Apollo-kernel/mechatronics/M0603A快速使用.pdf

# 快速使用步骤：

①先需要准备一个 USB 转 TTL 模块
②电脑准备一个串口调试助手上位机
③准备一个直流电源，按图示接好线，转接板的 TX 接串口 TX，RX 接串口 RX（如果不行可尝试交叉）

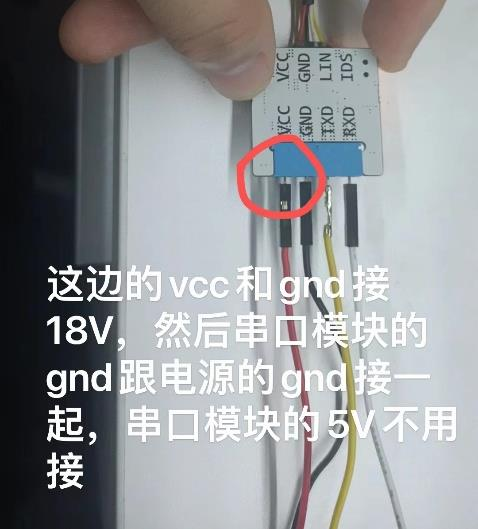
[picture p8: figure]

④固定好电机，电机为外转子（必须固定，电流环下电机会高速旋转） ⑤电源电压调至 18V,限流 1A
⑥串口助手配置

⑦上电后，串口助手先发使能指令（把转接板 ID 拨码拨至 ID1，中途改 ID 需要重新上电）

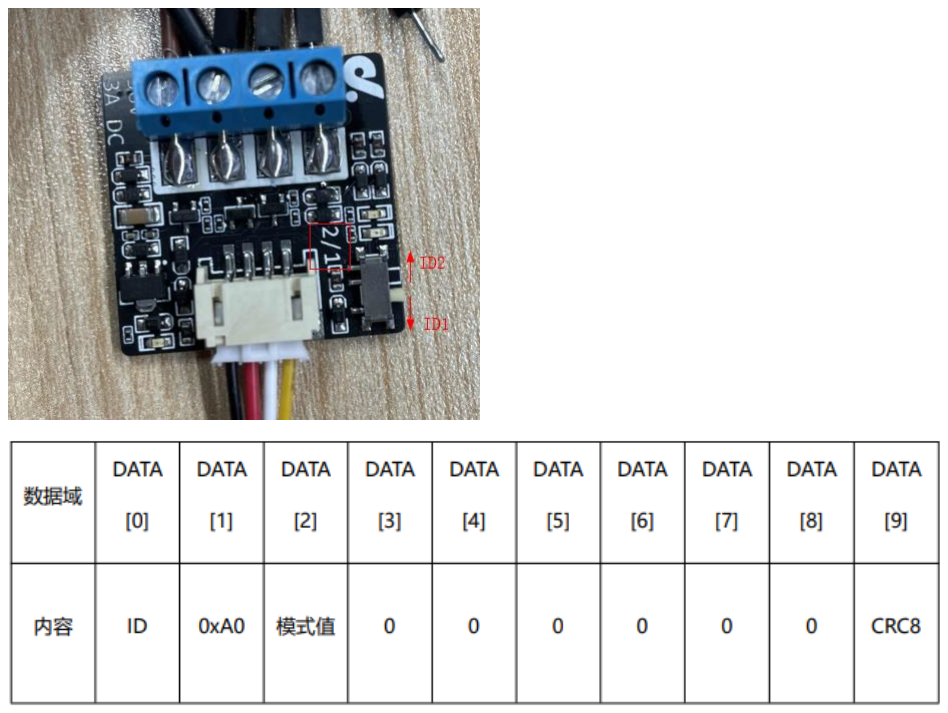
[picture p9: figure]

使能指令：发送(hex 发送)-> 01 A0 08 00 00 00 00 00 00 6F

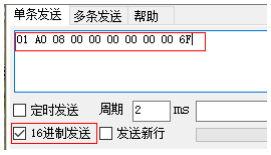
[picture p10: figure]

（其他模式操作请查看规格书）
⑧使能后默认运行电流环，即可发送电流环指令
电流指令：发送(hex 发送)-> 01 64 0B B8 00 00 00 00 00 40（对应电流值 3000）

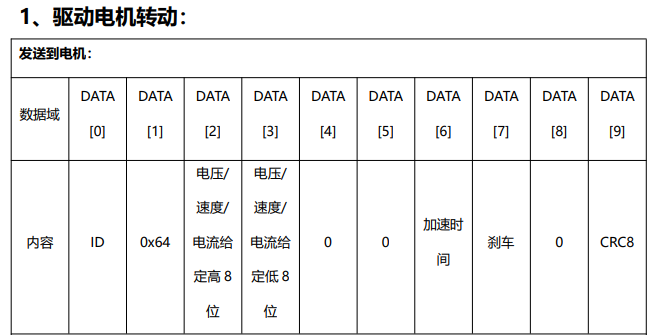
[picture p11: figure]

发送完毕后电机会旋转至满速，其他电流值同理，值越大出力越大

其他

1、指令发送需要计算 CRC 值，在线计算参考链接：http://www.ip33.com/crc.html

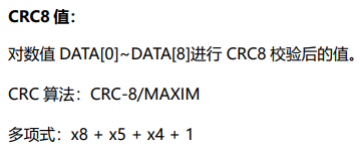
[picture p12: figure]

2、其他控制操作请参考规格书
