Apollo-kernel/mechatronics/.gitbook/assets/image.png

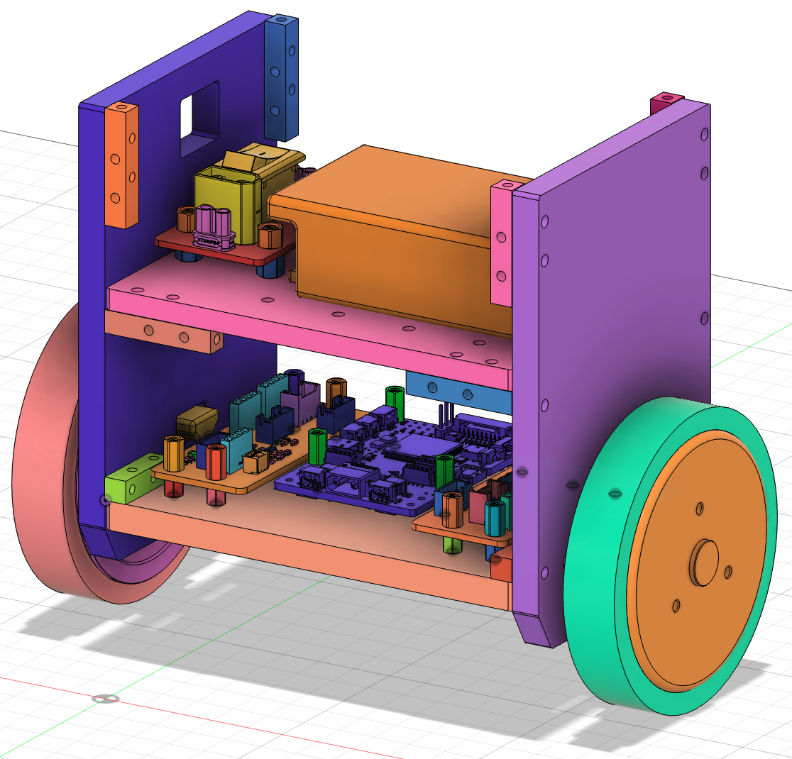
.gitbook/assets/image.png
