Apollo-kernel/mechatronics/H7_1.2.1/H7_1.2.1.ioc

Mcu.UserName=STM32H723VGTx
PA10.Signal=USART1_RX
PA13(JTMS/SWDIO).Signal=DEBUG_JTMS-SWDIO
PA14(JTCK/SWCLK).Signal=DEBUG_JTCK-SWCLK
PA5.Signal=ADCx_INP19
PA7.Signal=SPI6_MOSI
PA9.Signal=USART1_TX
PC12.Signal=SPI6_SCK
PC13.GPIO_Label=Power_OUT2_EN
PC13.Signal=GPIO_Output
PC14-OSC32_IN.GPIO_Label=Power_OUT1_EN
PC14-OSC32_IN.Signal=GPIO_Output
PC15-OSC32_OUT.GPIO_Label=Power_5V_EN
PC15-OSC32_OUT.Signal=GPIO_Output
PC4.Signal=ADCx_INP4
PH0-OSC_IN.Signal=RCC_OSC_IN
PH1-OSC_OUT.Signal=RCC_OSC_OUT
