Apollo-kernel/mechatronics/H7_2.1.2/Core/Src/main.c

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
/* Includes ------------------------------------------------------------------*/
#include "main.h"
#include "cmsis_os.h"
#include "bdma.h"
#include "dma.h"
#include "spi.h"
#include "usart.h"
#include "gpio.h"

/* USER CODE BEGIN Includes */
#include <string.h>
/* USER CODE END Includes */


/* USER CODE BEGIN PV */
/* UART relay host (USART1) <-> motor (UART7, half-duplex) - from L475_M0603_Feedback */
uint8_t usart1_rx_data[256] = {0};
uint8_t uart7_rx_data[256] = {0};
uint8_t usart1_tx_buf[256] = {0};
uint8_t uart7_tx_buf[256] = {0};
volatile uint16_t usart1_tx_len = 0;
volatile uint16_t uart7_tx_len = 0;
volatile uint8_t usart1_tx_busy = 0;
volatile uint8_t uart7_tx_busy = 0;

/* M0603 motor command packets (10 bytes) - for direct motor control */
const uint8_t m0603_enable[10]      = {0x01, 0xA0, 0x08, 0x00, 0x00, 0x00, 0x00, 0x00, 0x00, 0x6F};
const uint8_t m0603_speed_loop[10]   = {0x01, 0xA0, 0x02, 0x00, 0x00, 0x00, 0x00, 0x00, 0x00, 0xE4};
const uint8_t m0603_30RPM[10]       = {0x01, 0x64, 0x01, 0x2C, 0x00, 0x00, 0x00, 0x00, 0x00, 0xA6};
const uint8_t m0603_10RPM_CW[10]    = {0x01, 0x64, 0x00, 0x64, 0x00, 0x00, 0x00, 0x00, 0x00, 0x4F};
const uint8_t m0603_10RPM_CCW[10]   = {0x01, 0x64, 0xFF, 0x9C, 0x00, 0x00, 0x00, 0x00, 0x00, 0x9A};
const uint8_t m0603_30RPM_CCW[10]   = {0x01, 0x64, 0xFE, 0xD4, 0x00, 0x00, 0x00, 0x00, 0x00, 0x73};
/* USER CODE END PV */

void SystemClock_Config(void);
void PeriphCommonClock_Config(void);
void MX_FREERTOS_Init(void);
/* USER CODE BEGIN 0 */
/* UART7->USART1 relay: motor feedback on UART7 is forwarded up to host on USART1.
 * (No commands are forwarded from USART1 down to the motors in this mode.) */
static void UART7_StartRxDMA(void)
{
  HAL_UART_DMAStop(&huart7);
  HAL_HalfDuplex_EnableReceiver(&huart7);
  if (HAL_UARTEx_ReceiveToIdle_DMA(&huart7, uart7_rx_data, sizeof(uart7_rx_data)) == HAL_OK)
  {
    __HAL_DMA_DISABLE_IT(huart7.hdmarx, DMA_IT_HT);
  }
}

static void UART7_StopRxDMA(void)
{
  HAL_UART_DMAStop(&huart7);
}
/* USER CODE END 0 */

/**
  * @brief  The application entry point.
  * @retval int
  */
int main(void)
{

  /* Enable the CPU Cache */

  /* Enable I-Cache---------------------------------------------------------*/
  SCB_EnableICache();

  /* MCU Configuration--------------------------------------------------------*/

  /* Reset of all peripherals, Initializes the Flash interface and the Systick. */
  HAL_Init();

  /* Configure the system clock */
  SystemClock_Config();

  /* Configure the peripherals common clocks */
  PeriphCommonClock_Config();

  /* Initialize all configured peripherals */
  MX_GPIO_Init();
  MX_BDMA_Init();
  MX_DMA_Init();
  MX_SPI6_Init();
  MX_USART1_UART_Init();
  MX_USART10_UART_Init();
  MX_UART7_Init();
  /* USER CODE BEGIN 2 */
  HAL_GPIO_TogglePin(Power_5V_EN_GPIO_Port, Power_5V_EN_Pin);
  HAL_GPIO_TogglePin(Power_OUT2_EN_GPIO_Port, Power_OUT2_EN_Pin);
  HAL_GPIO_TogglePin(Power_OUT1_EN_GPIO_Port, Power_OUT1_EN_Pin);
  HAL_Delay(300);
  /* UART7 RX DMA/relay disabled while using UART7 for periodic motor TX only. */
  /* USER CODE END 2 */

  /* Call init function for freertos objects (in cmsis_os2.c) */
  MX_FREERTOS_Init();

  /* Start scheduler */
  osKernelStart();

  /* We should never get here as control is now taken by the scheduler */

  /* Infinite loop */
  /* USER CODE BEGIN WHILE */
  while (1)
  {
    /* USER CODE END WHILE */

    /* USER CODE BEGIN 3 */
  }
  /* USER CODE END 3 */
}

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
/* USER CODE BEGIN 4 */
void HAL_UART_ErrorCallback(UART_HandleTypeDef *huart)
{
  if (huart->Instance == UART7)
  {
    HAL_UART_DMAStop(&huart7);
    HAL_UART_Abort(&huart7);
    __HAL_UART_CLEAR_OREFLAG(&huart7);
    __HAL_UART_CLEAR_FEFLAG(&huart7);
    __HAL_UART_CLEAR_NEFLAG(&huart7);
    __HAL_UART_CLEAR_PEFLAG(&huart7);
    __HAL_UART_CLEAR_IDLEFLAG(&huart7);
    uart7_tx_busy = 0;
    UART7_StartRxDMA();
  }
}

void HAL_UART_TxCpltCallback(UART_HandleTypeDef *huart)
{
  if (huart->Instance == UART7)
  {
    uart7_tx_busy = 0;
    HAL_HalfDuplex_EnableReceiver(&huart7);
    UART7_StartRxDMA();
  }
}

void HAL_UARTEx_RxEventCallback(UART_HandleTypeDef *huart, uint16_t Size)
{
  if (huart->Instance == UART7)
  {
    if ((Size > 0U) && (Size <= sizeof(usart1_tx_buf)) && (!usart1_tx_busy))
    {
      memcpy(usart1_tx_buf, uart7_rx_data, Size);
      usart1_tx_len = Size;
      if (HAL_UART_Transmit_DMA(&huart1, usart1_tx_buf, usart1_tx_len) == HAL_OK)
      {
        usart1_tx_busy = 1;
      }
    }
    UART7_StartRxDMA();
  }
}
/* USER CODE END 4 */

/**
  * @brief  Period elapsed callback in non blocking mode
  * @note   This function is called  when TIM6 interrupt took place, inside
  * HAL_TIM_IRQHandler(). It makes a direct call to HAL_IncTick() to increment
  * a global variable "uwTick" used as application time base.
  * @param  htim : TIM handle
  * @retval None
  */
void HAL_TIM_PeriodElapsedCallback(TIM_HandleTypeDef *htim)
{
  if (htim->Instance == TIM6)
  {
    HAL_IncTick();
  }
}

/**
  * @brief  This function is executed in case of error occurrence.
  * @retval None
  */
void Error_Handler(void)
{
  /* USER CODE BEGIN Error_Handler_Debug */
  /* User can add his own implementation to report the HAL error return state */
  __disable_irq();
  while (1)
  {
  }
  /* USER CODE END Error_Handler_Debug */
}
#ifdef USE_FULL_ASSERT
/**
  * @brief  Reports the name of the source file and the source line number
  *         where the assert_param error has occurred.
  * @param  file: pointer to the source file name
  * @param  line: assert_param error line source number
  * @retval None
  */
void assert_failed(uint8_t *file, uint32_t line)
{
  /* USER CODE BEGIN 6 */
  /* User can add his own implementation to report the file name and line number,
     ex: printf("Wrong parameters value: file %s on line %d\r\n", file, line) */
  /* USER CODE END 6 */
}
#endif /* USE_FULL_ASSERT */
