Apollo-kernel/mechatronics/Agile_2.6.1/Core/Inc/main.h

#define Power_OUT2_EN_Pin GPIO_PIN_13
#define Power_OUT2_EN_GPIO_Port GPIOC
#define Power_OUT1_EN_Pin GPIO_PIN_14
#define Power_OUT1_EN_GPIO_Port GPIOC
#define Power_5V_EN_Pin GPIO_PIN_15
#define Power_5V_EN_GPIO_Port GPIOC
#define ACC_CS_Pin GPIO_PIN_0
#define ACC_CS_GPIO_Port GPIOC
#define GYRO_CS_Pin GPIO_PIN_3
#define GYRO_CS_GPIO_Port GPIOC
#define DI_Pin GPIO_PIN_0
#define DI_GPIO_Port GPIOA
#define DO_Pin GPIO_PIN_2
#define DO_GPIO_Port GPIOA
#define CS_Pin GPIO_PIN_9
#define CS_GPIO_Port GPIOE
#define CLK_Pin GPIO_PIN_13
#define CLK_GPIO_Port GPIOE
