Apollo-kernel/mechatronics/oled/l475_clion_cubeide/Core/oledlib/oled_font.c

/*
	Copyright (c) [2019] [一只程序缘 jiezhuo]
	[https://gitee.com/jiezhuonew/oledlib] is licensed under the Mulan PSL v1.
	You can use this software according to the terms and conditions of the Mulan PSL v1.
	You may obtain a copy of Mulan PSL v1 at:
		http://license.coscl.org.cn/MulanPSL
	THIS SOFTWARE IS PROVIDED ON AN "AS IS" BASIS, WITHOUT WARRANTIES OF ANY KIND, EITHER EXPRESS OR
	IMPLIED, INCLUDING BUT NOT LIMITED TO NON-INFRINGEMENT, MERCHANTABILITY OR FIT FOR A PARTICULAR
	PURPOSE.
	See the Mulan PSL v1 for more details.
	
	此c文件用于对字体进行操作 在oled.draw中被DrawChar()等函数被调用
	主要有设置字体背景颜色 
	(字体颜色同划线线条颜色GetDrawColor())
	字体尺寸
	基础字符字库(取模方式见字库顶部)
	汉字字库(取模方式见字库顶部)
*/

#include "oled_font.h"

static Type_textbk _TextBk=TEXT_BK_NULL;
static unsigned char _FontSize=0;			//默认字体尺寸 为8x6

/////////////////////////////////////////////////////////////////////////////////
//设置字体填充的背景颜色
//1白0黑 
//TEXT_BK_NULL：无背景，TEXT_BK_NOT_NULL：有背景
void SetTextBkMode(Type_textbk value)
{
	_TextBk=value;
}
Type_textbk GetTextBkMode(void)
{
	return _TextBk;
}

//在显示字体前先设置需要显示的字体的尺寸
//尺寸有 0 1 2 3
//对应像素是 0 8 16 24
//0是默认字体 		也就是F8X16[]		大小8x16
//1是原作者字体 	也就是font5x7[]		大小6x8
//2是1的2倍放大							大小12x16
//3是1的3倍放大							大小18x24
void SetFontSize(unsigned char value)
{
	_FontSize=value;
}
unsigned char GetFontSize(void)
{
	return _FontSize;
}


//基础图形英文字符字库
//若要显示更大的字符按照此字符比例放大即可
//详情见DrawChar()
const unsigned char font5x7[] =
{
    0x00, 0x00, 0x00, 0x00, 0x00,
    0x3E, 0x5B, 0x4F, 0x5B, 0x3E,
    0x3E, 0x6B, 0x4F, 0x6B, 0x3E,
    0x1C, 0x3E, 0x7C, 0x3E, 0x1C,
    0x18, 0x3C, 0x7E, 0x3C, 0x18,
    0x1C, 0x57, 0x7D, 0x57, 0x1C,
    0x1C, 0x5E, 0x7F, 0x5E, 0x1C,
    0x00, 0x18, 0x3C, 0x18, 0x00,
    0xFF, 0xE7, 0xC3, 0xE7, 0xFF,
    0x00, 0x18, 0x24, 0x18, 0x00,
    0xFF, 0xE7, 0xDB, 0xE7, 0xFF,
    0x30, 0x48, 0x3A, 0x06, 0x0E,
    0x26, 0x29, 0x79, 0x29, 0x26,
    0x40, 0x7F, 0x05, 0x05, 0x07,
    0x40, 0x7F, 0x05, 0x25, 0x3F,
    0x5A, 0x3C, 0xE7, 0x3C, 0x5A,
    0x7F, 0x3E, 0x1C, 0x1C, 0x08,
    0x08, 0x1C, 0x1C, 0x3E, 0x7F,
    0x14, 0x22, 0x7F, 0x22, 0x14,
    0x5F, 0x5F, 0x00, 0x5F, 0x5F,
    0x06, 0x09, 0x7F, 0x01, 0x7F,
    0x00, 0x66, 0x89, 0x95, 0x6A,
    0x60, 0x60, 0x60, 0x60, 0x60,
    0x94, 0xA2, 0xFF, 0xA2, 0x94,
    0x08, 0x04, 0x7E, 0x04, 0x08,
    0x10, 0x20, 0x7E, 0x20, 0x10,
    0x08, 0x08, 0x2A, 0x1C, 0x08,
    0x08, 0x1C, 0x2A, 0x08, 0x08,
    0x1E, 0x10, 0x10, 0x10, 0x10,
    0x0C, 0x1E, 0x0C, 0x1E, 0x0C,
    0x30, 0x38, 0x3E, 0x38, 0x30,
    0x06, 0x0E, 0x3E, 0x0E, 0x06,
    0x00, 0x00, 0x00, 0x00, 0x00,
    0x00, 0x00, 0x5F, 0x00, 0x00,
    0x00, 0x07, 0x00, 0x07, 0x00,
    0x14, 0x7F, 0x14, 0x7F, 0x14,
    0x24, 0x2A, 0x7F, 0x2A, 0x12,
    0x23, 0x13, 0x08, 0x64, 0x62,
    0x36, 0x49, 0x56, 0x20, 0x50,
    0x00, 0x08, 0x07, 0x03, 0x00,
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
};


/****************************************8*16的点阵************************************/
//const unsigned char F8X16[]=	  
//{
//  0x00,0x00,0x00,0x00,0x00,0x00,0x00,0x00,0x00,0x00,0x00,0x00,0x00,0x00,0x00,0x00,// 0
//  0x00,0x00,0x00,0xF8,0x00,0x00,0x00,0x00,0x00,0x00,0x00,0x33,0x30,0x00,0x00,0x00,//! 1
//  0x00,0x10,0x0C,0x06,0x10,0x0C,0x06,0x00,0x00,0x00,0x00,0x00,0x00,0x00,0x00,0x00,//" 2
//  0x40,0xC0,0x78,0x40,0xC0,0x78,0x40,0x00,0x04,0x3F,0x04,0x04,0x3F,0x04,0x04,0x00,//# 3
//  0x00,0x70,0x88,0xFC,0x08,0x30,0x00,0x00,0x00,0x18,0x20,0xFF,0x21,0x1E,0x00,0x00,//$ 4
//  0xF0,0x08,0xF0,0x00,0xE0,0x18,0x00,0x00,0x00,0x21,0x1C,0x03,0x1E,0x21,0x1E,0x00,//% 5
//  0x00,0xF0,0x08,0x88,0x70,0x00,0x00,0x00,0x1E,0x21,0x23,0x24,0x19,0x27,0x21,0x10,//& 6
//  0x10,0x16,0x0E,0x00,0x00,0x00,0x00,0x00,0x00,0x00,0x00,0x00,0x00,0x00,0x00,0x00,//' 7
//  0x00,0x00,0x00,0xE0,0x18,0x04,0x02,0x00,0x00,0x00,0x00,0x07,0x18,0x20,0x40,0x00,//( 8
//  0x00,0x02,0x04,0x18,0xE0,0x00,0x00,0x00,0x00,0x40,0x20,0x18,0x07,0x00,0x00,0x00,//) 9
//  0x40,0x40,0x80,0xF0,0x80,0x40,0x40,0x00,0x02,0x02,0x01,0x0F,0x01,0x02,0x02,0x00,//* 10
//  0x00,0x00,0x00,0xF0,0x00,0x00,0x00,0x00,0x01,0x01,0x01,0x1F,0x01,0x01,0x01,0x00,//+ 11
//  0x00,0x00,0x00,0x00,0x00,0x00,0x00,0x00,0x80,0xB0,0x70,0x00,0x00,0x00,0x00,0x00,//, 12
//  0x00,0x00,0x00,0x00,0x00,0x00,0x00,0x00,0x00,0x01,0x01,0x01,0x01,0x01,0x01,0x01,//- 13
//  0x00,0x00,0x00,0x00,0x00,0x00,0x00,0x00,0x00,0x30,0x30,0x00,0x00,0x00,0x00,0x00,//. 14
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
{0x00,0x00,0x00,0x07,0xFF,0x70,0x00,0x00},
{0x00,0x00,0x00,0x07,0xF7,0x70,0x00,0x00},
{0x00,0x00,0x00,0x07,0x77,0x70,0x00,0x00},
{0x00,0x00,0x00,0x07,0xF7,0x70,0x00,0x00},
{0x00,0x00,0x00,0x07,0xF7,0x00,0x00,0x00},
{0x00,0x00,0x00,0x07,0xF7,0x00,0x00,0x00},
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
};
