Apollo-kernel/mechatronics/oled/l475_clion_cubeide/Core/oledlib/oled_debug.c

/*
	Copyright (c) [2019] [一只程序缘 jiezhuo]
	[https://gitee.com/jiezhuonew/oledlib] is licensed under the Mulan PSL v1.
	You can use this software according to the terms and conditions of the Mulan PSL v1.
	You may obtain a copy of Mulan PSL v1 at:
		http://license.coscl.org.cn/MulanPSL
	THIS SOFTWARE IS PROVIDED ON AN "AS IS" BASIS, WITHOUT WARRANTIES OF ANY KIND, EITHER EXPRESS OR
	IMPLIED, INCLUDING BUT NOT LIMITED TO NON-INFRINGEMENT, MERCHANTABILITY OR FIT FOR A PARTICULAR
	PURPOSE.
	See the Mulan PSL v1 for more details.
	
	此c文件用于串口调试printf 不同的是发送的数据被显示在液晶屏上
	唯一被外部调用的函数是OledPrintf() 同printf的功能
	其他函数都是为OledPrintf()服务
*/

#include "oled_debug.h"
#include "oled_font.h"
#include "oled_config.h"
#include "oled_draw.h"
#include "stdlib.h"
#include "string.h"
#include "stdarg.h"

static int _cursor_x=0;
static int _cursor_y=0;
static unsigned char wrap=1;

void SetTextWrap(unsigned char w)
{
	wrap = w;
}

void SetCursor(int x, int y)
{
	_cursor_x = x;
	_cursor_y = y;
}

//次方函数
static unsigned long m_pow(int x,int y)
{
	unsigned long sum = 1;
	
	while(y--)
	{
		sum *= x;
	}
	return sum;
}

//打印字符
void m_putchar(const char c)
{
	unsigned char tmp=GetFontSize();
	if (c == '\n')
	{
		_cursor_y += 8;
		_cursor_x = 0;
	}
	else if (c == '\r')
	{

	}
	else
	{
		SetFontSize(1);
		DrawChar(_cursor_x, _cursor_y, c);
		SetFontSize(tmp);
		_cursor_x += 6;
		if (wrap && (_cursor_x > (SCREEN_COLUMN - 6)))
		{
			m_putchar('\n');
		}
	}     
}
 
//打印字符串
void m_putstr(const char *str)
{
	while(*str)
	{
		m_putchar(*str++);
	}
}

//模仿printf功能显示到oled上
int OledPrintf(const char *str,...)
{
	va_list ap;              //定义一个可变 参数的（字符指针） 
	int val,r_val;
	char count,ch;
	char *s = NULL;
	int res = 0;             //返回值

	va_start(ap,str);        //初始化ap
	while('\0' != *str)//str为字符串,它的最后一个字符肯定是'\0'（字符串的结束符）
	{
		switch(*str)
		{
			//遇到百分号 此时要替换为参数
			case '%':
			str++;
			switch(*str)
			{
				//10进制输出
				case 'd':
					val = va_arg(ap, int); 
					r_val = val; 
					count = 0; 
				
					while(r_val)
					{
						count++;         		//整数的长度
						r_val /= 10;
					}
					res += count;         		//返回值长度增加? 
					r_val = val; 
					while(count)
					{ 
					ch = r_val / m_pow(10,count - 1);
					r_val %= m_pow(10,count - 1);
					m_putchar(ch + '0');     	//数字到字符的转换 
					count--;
					}
				break;
				
				//16进制输出 
					case 'x':
					val = va_arg(ap, int); 
					r_val = val; 
					count = 0;
					while(r_val) 
					{
						count++;     //整数的长度 
						r_val /= 16; 
					}
					res += count;     //返回值长度增加? 
					r_val = val; 
					while(count) 
					{
						ch = r_val / m_pow(16, count - 1); 
						r_val %= m_pow(16, count - 1);
						if(ch <= 9)
						m_putchar(ch + '0');	//数字到字符的转换 
						else 
						m_putchar(ch - 10 + 'a'); 
						count--;
					}
				break;
				
				//发送字符串
				case's':
					s = va_arg(ap, char *); 	
					m_putstr(s);          //字符串,返回值为字符指针 
					res += strlen(s);   //返回值长度增加 ? 
					break;
					case 'c':
					m_putchar( (char)va_arg(ap, int )); //大家猜为什么不写char，而要写int 
					res += 1;
				break;
				default :;
			}
			break;
			
			//遇到字符串末尾 回车换行
			case '\n':	m_putchar('\n'); res += 1;	break;
			case '\r':	m_putchar('\r'); res += 1;	break;
			
			default :          //显示原来的第一个参数的字符串(不是..里的参数o)
				
			m_putchar(*str);
			res += 1;
		}
		str++;
	}
	
	//显示到底部了 从头刷新显示
	if(_cursor_y+8>=63)
		_cursor_y=0;
	
	va_end(ap);
	UpdateScreen();
	return res;
}
