Apollo-kernel/mechatronics/H7_adc_uart/Core/Inc/ws2812.h

#ifndef __WS2812_H__
#define __WS2812_H__

#include "main.h"

#define WS2812_SPI_UNIT   hspi6
extern SPI_HandleTypeDef WS2812_SPI_UNIT;

void WS2812_Ctrl(uint8_t r, uint8_t g, uint8_t b);

#endif /* __WS2812_H__ */
