Apollo-kernel/mechatronics/oled/l475_clion_cubeide/Core/oledlib/oled_bmp.h

#ifndef OLED_BMP_H
#define OLED_BMP_H
extern const unsigned char BmpTest1[];
extern const unsigned char BmpTest2[];
extern const unsigned char BmpTest3[];
extern const unsigned char Like[];
extern const unsigned char Panda[];
#endif
