Apollo-kernel/mechatronics/(commit log)

2026-02-12 adding all files
    [daplink.cfg, stlink.cfg]
2026-02-21 spi rtos
    [daplink.cfg, stlink.cfg]
2026-03-07 added motor control to adc_uart folder
2026-03-08 added LED flash to code
2026-03-11 pushing changes to monitor motor info from stm32
    [daplink.cfg, stlink.cfg]
2026-03-11 added 2.0.0
    [daplink.cfg, stlink.cfg]
2026-03-12 added 2.1.2
    [daplink.cfg, stlink.cfg]
2026-03-14 bmi088 & pid
    [daplink.cfg, stlink.cfg]
2026-04-08 fixed positive feedback loop
    [balance_task.c]
2026-04-11 add Agile_2.5.5
    [daplink.cfg, stlink.cfg]
2026-04-19 moves forward at 15rpm while still balancing
    [daplink.cfg, stlink.cfg]
2026-04-19 pushed 360 degree spin
    [daplink.cfg, stlink.cfg]
2026-04-19 robot travels backwards at 15rpm
    [daplink.cfg, stlink.cfg]
2026-04-26 combined rotation+driving functionality (user controllable)
    [daplink.cfg, stlink.cfg]
2026-04-26 add forbackward & ws2812 controlled by slider & button in vofa
    [daplink.cfg, stlink.cfg]
2026-04-26 fixed timeout issue causing robot to spin excessively
    [balance_task.c]
2026-04-27 made rotation controllable via vofa
    [daplink.cfg, stlink.cfg]
2026-04-28 add initial camera
    [partitions.csv]
2026-04-28 add joystick in vofa
    [daplink.cfg, stlink.cfg]
2026-04-29 added robustness and reliability essentials to uart1
2026-04-29 switched to a fixed frame control system
    [balance_task.c]
2026-05-05 add just voltage sensing of battery
    [daplink.cfg, stlink.cfg]
2026-05-05 added (analog) voltage reader to UI interface
2026-05-10 fixed camera so that it streams on/off while being controllablevia joystick
    [stlink.cfg]
