Apollo-kernel/mechatronics/(notices)

Notices in the files:
oled/l475_clion_cubeide/Core/oledlib/oled_font.c:
Copyright (c) [2019] [Ò»Ö»³ÌÐòÔµ jiezhuo]
H7_2.1.2/Core/Src/main.c:
Copyright (c) 2026 STMicroelectronics.
All rights reserved.
This software is licensed under terms that can be found in the LICENSE file
